mitulpatelp112-svg/Autonomous-drone/frame/ANALYSIS.md

# Frame loads and stresses

Generated by `frame/analysis.py` from the CAD and your Excel motor data. Re-run after
changing `params.py`. Estimates, not a substitute for testing a printed arm.

## Inputs

| Item | Value |
|---|---|
| All-up weight (HOOVO pack + 200 g payload) | **2,367 g** (23.2 N) |
| Printed frame (from CAD, 50% fill) | 672 g |
| Hover thrust per motor | 5.8 N (592 g) |
| Max thrust per motor (Motor sheet, 22.2 V, CF16x5.5) | 17.1 N (1,740 g) |
| Thrust-to-weight | 2.94 : 1 |
| Material | PETG, E = 2000 MPa, strength 45 MPa along lines / 25 MPa across layers, safety factor 3 |

Mass breakdown:

| Part | g |
|---|---|
| Frame (printed, from CAD volume) | 672 |
| 4 x 5010 360KV motor (listing: 80 g) | 320 |
| 4 x 30 A OPTO ESC (ReadytoSky listings: 30 g) | 120 |
| 4 x 16-inch carbon prop (est. 22 g) | 88 |
| Kakute H7 v1.5 (8 g, Holybro) | 8 |
| Power board with XT60 (11 g, listing) | 11 |
| RP3 receiver (4.6 g, RadioMaster) | 5 |
| SEQURE M10 GPS (12 g, SEQURE) | 12 |
| Finder buzzer (est. 4 g) | 4 |
| Wiring, inserts, bolts, straps (est.) | 90 |
| HOOVO 6S 6200 mAh (837 g, listing) | 837 |
| Payload (mission: 200 g) | 200 |

## Arms (cantilever from the body tunnel exit, r = 133 mm, to the motor, r = 340 mm)

| Check | Value | Allowed | Result |
|---|---|---|---|
| Bending moment at the tunnel exit, full thrust | 3.53 N·m | | |
| Peak bending stress (at 133 mm from centre) | 2.24 MPa | 15.0 MPa | OK |
| Tip deflection at hover | 0.49 mm | < 2 mm | OK |
| Tip deflection at full thrust | 1.44 mm | < 4 mm | OK |
| Motor torque reaction | 0.31 N·m | | |
| Torsion shear in the arm walls | 0.13 MPa | 6.7 MPa | OK |
| First bending frequency of an arm | 47 Hz | | |
| Motor speed at hover / full thrust (est.) | 66 / 113 Hz | | |
| Blade-pass at hover (2 blades) | 132 Hz | | |

The arm's first bending frequency (~47 Hz, a rough estimate) sits 28% below the hover rotor speed.
The rotors only pass through it briefly at low throttle (descents), which is normal for printed frames. Do not make the arms
moderately stiffer: that would move the frequency onto hover speed. Instead: balance the props, soft-mount the flight
controller on its grommets, and turn on ArduPilot's throttle-based harmonic notch (the ESCs have no RPM telemetry).
After the first hover, check the FFT in the flight log; if a peak shows up near hover speed, tell me and I will retune the arm.

## Arm-to-body joint (arm in the tunnel, held by 2 x M3)

Under thrust the arm presses **up** on the tunnel roof lip and **down** on the floor at its root,
so the bolts are not loaded in normal flight; they hold the arm in and take crash loads.

| Check | Value | Allowed | Result |
|---|---|---|---|
| Force on the roof lip | 99.2 N | | |
| Force on the floor at the root | 82.2 N | | |
| Bearing stress on the lip (3 mm strip) | 1.18 MPa | 15.0 MPa | OK |
| Roof bending (7 mm roof, 28.5 mm span) | 2.89 MPa | 15.0 MPa | OK |
| Side walls pulled across layers | 0.44 MPa | 8.3 MPa | OK |

## Curved spring legs

Each leg is a C-shaped PETG leaf (28 mm wide, 4.8 mm thick, 144 mm long, bowing 50 mm outward).
On touchdown the C closes up and stores the landing energy in bending. Modelled as a curved beam
(linear, small deflections) with a sideways skid of 0.3 x the vertical force either way.

| Property | Value |
|---|---|
| Spring rate per leg | 2.60 N/mm |
| Sag when sitting on the ground | 2.2 mm |
| Battery-to-ground gap, unloaded / resting | 56.8 / 54.5 mm |

| Touchdown | Energy per leg | Peak force per leg | Leg compresses | Peak deceleration | Leaf stress (limit 30) | Battery gap left |
|---|---|---|---|---|---|---|
| 0.5 m/s on 4 legs | 0.07 J | 19.6 N | 7.5 mm | 3.4 g | 12.4 MPa OK | 47.0 mm |
| 1.0 m/s on 4 legs | 0.30 J | 39.2 N | 15.1 mm | 6.8 g | 24.8 MPa OK | 39.4 mm |
| 1.2 m/s on 4 legs | 0.43 J | 47.0 N | 18.1 mm | 8.1 g | 29.7 MPa OK | 36.4 mm |
| 1.2 m/s on 2 legs | 0.85 J | 66.5 N | 25.6 mm | 5.7 g | 42.0 MPa  | 28.9 mm |

The 0.5 m/s case is a normal ArduPilot landing: the leaf sees about 12 MPa, low enough for
thousands of landings. The 1.2 m/s case is the design hard landing. Tipping onto two legs at 1.2 m/s
reaches 42 MPa, past the ~40 MPa where the leaf is expected to bend for good:
those legs may need replacing after a hard tip-over (print a spare pair).

**Where it gives up.** The leaf is expected to bend permanently or crack at about 40 MPa: 63.3 N per leg,
after 24.4 mm of travel. That is a 1.6 m/s touchdown on 4 legs or 1.1 m/s on 2. The legs are
the weak link on purpose: they are cheap bolt-on parts, and everything behind them stays well inside its limits at that load:

| At the leg's break load (63.3 N) | Value | Allowed | Result |
|---|---|---|---|
| Battery-to-ground gap left | 30.1 mm | > 0 | OK |
| Worst pull on a leg bolt / insert | 41 N | ~167 N (insert pull-out 500 N / 3) | OK |
| Arm bending stress from the leg push | 3.1 MPa | 15.0 MPa | OK |
| Leaf stress from a sideways skid (stiff direction) | 3.2 MPa | 15.0 MPa | OK |

**Printing the legs:** on their side (the C lies flat on the bed), so the printed lines run along the curve and the leaf bends
along its lines, not across layers. Print them solid (100% infill or 6+ walls); a leaf with sparse infill is much
softer and weaker than this model. Each leg is about 40 g printed solid.

## Balance

| Item | Value |
|---|---|
| Centre of gravity height (z = 0 is the body underside) | -0.0 mm |
| Prop plane height (motor + adapter sizes in params.py) | 53.2 mm |
| CG below the props by | 53.3 mm |

A CG below the prop plane (battery underneath) is stable and easy to tune. Keep the battery
centred front-to-back: a 10 mm shift moves the CG 3.5 mm.

## Prop clearances

| Check | Value |
|---|---|
| Gap between neighbouring prop tips | 74.4 mm |
| Prop disc inner edge vs body tip (radius) | 136.8 mm vs 133.0 mm |

## Assumptions to check

- PETG strengths are typical datasheet values; printed parts vary. Weigh and bend-test one arm.
- Insert pull-out (~500 N for an M3 insert in PETG) is a rough figure; it depends on the insert and print settings.
- Motor speed is estimated from KV x volts x 0.85; your Motor sheet has no rpm at 22.2 V.
- Prop weight is an estimate. The motor's height, can diameter and prop adapter are measured from the listing photos;
  the ESC size is from a retailer listing for the same model. Measure yours and update `params.py`.

## Lift capacity

From your Motor sheet (CF16x5.5 at 22.2 V): 1740 g per motor at 12.5 A, so **6.96 kg** of thrust from all
four at full throttle, drawing about 50 A. Empty weight (everything but the payload) is 2,167 g.

**The power board is the limit, not the motors.** It is rated 25 A continuous / 30 A burst (from its listing), and all
four ESCs draw through it. At 30 A the motors make only about **5.08 kg** (4.52 kg at 25 A). Full throttle
(50 A) would overload it. Either keep throttle (and so payload) inside its rating, or wire the ESC power leads to a
board or harness rated for at least 70 A to unlock the motors' full thrust.

| Max payload | With this power board (5.08 kg usable thrust) | With a 70 A+ board (6.96 kg) |
|---|---|---|
| Thrust-to-weight 2.0 (responsive, recommended) | **372 g** | **1,313 g** |
| Thrust-to-weight 1.6 (calm air only, sluggish) | 1,006 g | 2,183 g |

| Payload | All-up weight | Thrust-to-weight (board / motors) | Hover thrust, % of max | Hover current (board limit 25 A) | Hover time (80% of 6200 mAh) | Hard landing limit for the legs |
|---|---|---|---|---|---|---|
| 0 g | 2,167 g | 2.34 / 3.21 | 31% | 8.7 A | 34 min | 1.27 m/s |
| 200 g | 2,367 g | 2.14 / 2.94 | 34% | 9.3 A | 32 min | 1.21 m/s |
| 500 g | 2,667 g | 1.90 / 2.61 | 38% | 11.4 A | 26 min | 1.14 m/s |
| 1,000 g | 3,167 g | 1.60 / 2.20 | 46% | 15.0 A | 20 min | 1.05 m/s |
| 1,313 g | 3,480 g | 1.46 / 2.00 | 50% | 17.3 A | 17 min | 1.00 m/s |

Hover time is the motor sheet's hover current plus 5 W of avionics, no wind or manoeuvring: real flights get less.
The spring legs were sized for the 200 g mission payload; heavier loads lower the touchdown speed they can take
without bending for good (last column). The arms are unaffected by payload: their worst case is full motor thrust.
