mitulpatelp112-svg/Autonomous-drone/frame/CLEARANCE.md

# Clearance and tool-access check

Generated by `frame/clearance.py` from the CAD. Each tool path is a straight cylinder from the screw head
outward (150 mm, a full screwdriver), 7 mm wide for an M3 head (5.5 mm) plus the driver tip.
Cable and strap paths are boxes the size of the bundle. Each is intersected with every printed part, the battery
(152 x 48.5 x 48 mm, from its listing), the motors with prop adapters, the ESCs with their bullets, leads and zip ties, and the prop discs, at the sizes in params.py. Pass = 0 mm³ overlap.

| Check | Paths | Result |
|---|---|---|
| Arm-to-body bolts (M3 x 40, from below) | 16 | all clear |
| Heat-set inserts (soldering iron from above) | 12 | all clear |
| Leg bolts (M3 x 8, from below) | 24 | all clear |
| Heat-set inserts (soldering iron from below) | 8 | all clear |
| Motor screws (M3, from under the pad) | 64 | all clear |
| Motor, ESC and wiring on the arm | 28 | all clear |
| ESC wire path (10 x 5.5 mm bundle) | 12 | all clear |
| Stack bolts (M3, from above) | 4 | all clear |
| GPS mast | 4 | all clear |
| Battery straps (20 mm) | 6 | all clear |
| Connectors | 2 | all clear |
| Part to part | 30 | all clear |

## Blocked paths

None.

## Thinnest walls between holes

| Between | mm |
|---|---|
| Joint bolt hole to wire channel (arm) | 1.8 |
| Joint bolt hole to arm side (before the 2 mm edge fillet) | 2.8 |
| Leg insert hole to nearest lightening slot (along the arm) | 1.9 |
| Mast lock insert (5.7 mm) to mast socket | 1.1 |
| Motor screw head (outer slot end) to pad pocket wall | 0.8 |
| Leg bolt head to spring leaf (below the pad) | 8.2 |
| Leg bolt head to foot | 3.2 |
| Strap slot to bay wall | 1.0 |

## Other clearances

| Item | mm |
|---|---|
| Ground clearance under the battery (legs 110 mm) | 56.8 |
| Gap between neighbouring prop tips | 74.4 |
| Prop disc inner edge to body tip (radius) | 3.8 |
| Prop disc inner edge to GPS mast | 76.2 |

## Order of assembly (so every screw stays reachable)

1. Inserts first: all heat-set inserts go in before anything is attached.
2. Motors onto the arms (screws from under the pad), then ESCs and zip ties.
3. Arms into the body; joint bolts from underneath, with the battery off.
4. Power board and Kakute from above; stack bolts from above.
5. Legs: drone upside down, bolts straight up into the arm undersides.
6. GPS mast into its socket at the back; lock screw from the rear.
7. Battery last, strapped underneath.
