mitulpatelp112-svg/Autonomous-drone/frame/out/parts.png

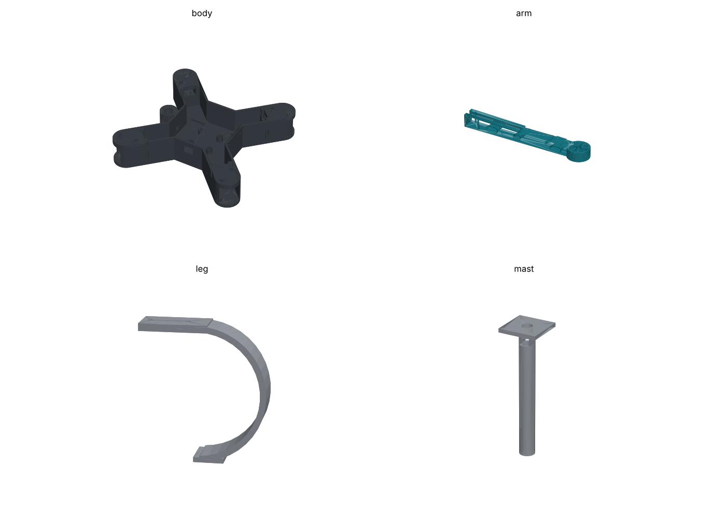
frame/out/parts.png
