mitulpatelp112-svg/Autonomous-drone/frame/out/assembly.step

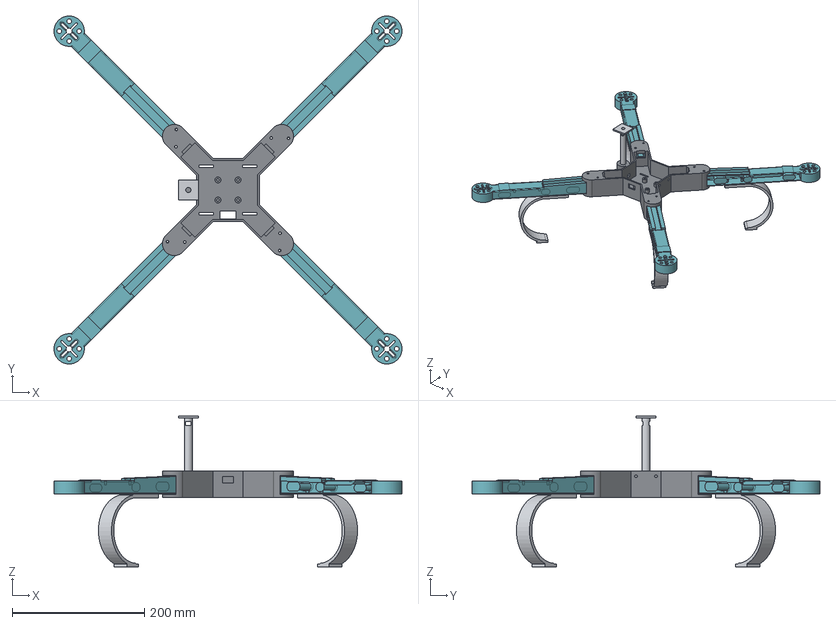
[picture p3: CAD file, 2026-10-27]
frame/out/assembly.step
526.8 x 526.8 x 228.2 mm
arm_1
leg_1
arm_2
leg_2
arm_3
leg_3
arm_4
leg_4
gps_mast
