mitulpatelp112-svg/Autonomous-drone/frame/out/leg.step

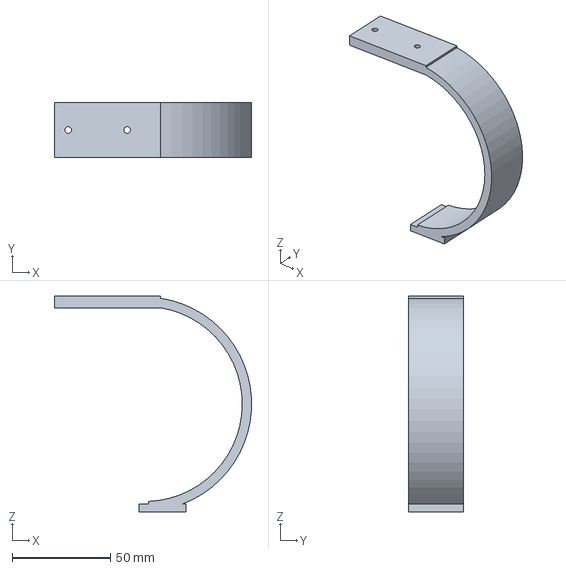
[picture p4: CAD file, 2026-10-27]
frame/out/leg.step
100.3 x 28.0 x 110.0 mm
