mitulpatelp112-svg/Autonomous-drone/frame/out/body.step

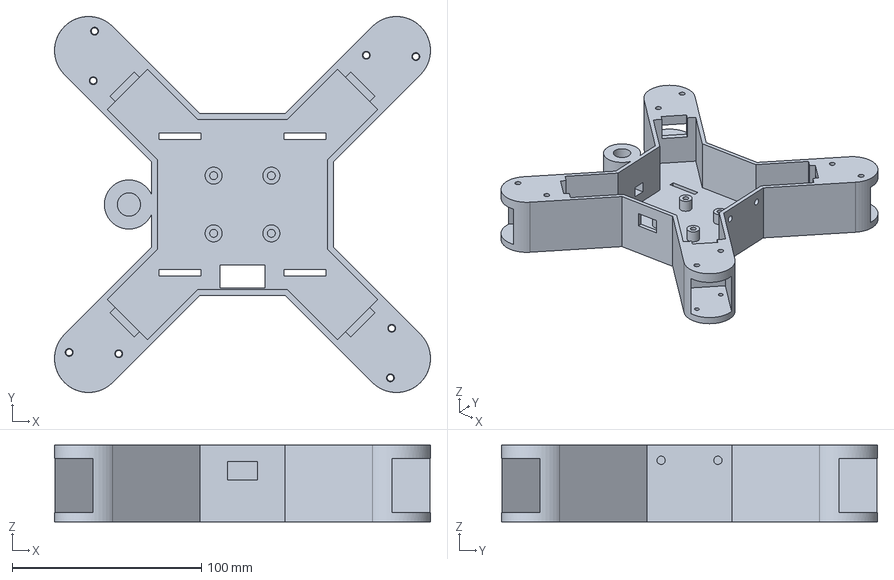
[picture p5: CAD file, 2026-10-27]
frame/out/body.step
198.6 x 198.6 x 40.5 mm
