mitulpatelp112-svg/Autonomous-drone/frame/out/mast.step

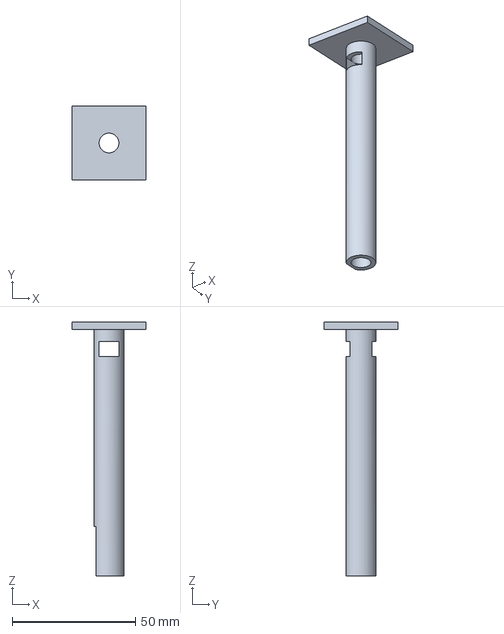
[picture p6: CAD file, 2026-10-27]
frame/out/mast.step
30.0 x 30.0 x 103.0 mm
