mitulpatelp112-svg/Autonomous-drone/frame/out/arm.step

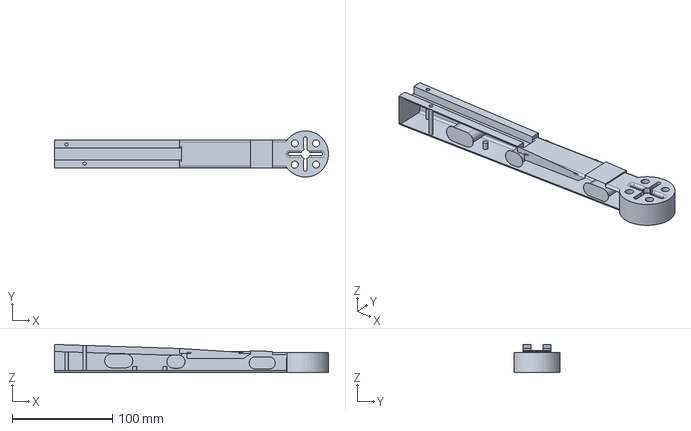
[picture p7: CAD file, 2026-10-27]
frame/out/arm.step
273.0 x 46.0 x 28.0 mm
