mitulpatelp112-svg/Autonomous-drone/(list of files, cad)

Other CAD files:
frame/out/arm.stl
frame/out/body.stl
frame/out/leg.stl
frame/out/mast.stl
