mitulpatelp112-svg/Autonomous-drone/frame/out/assembly.png

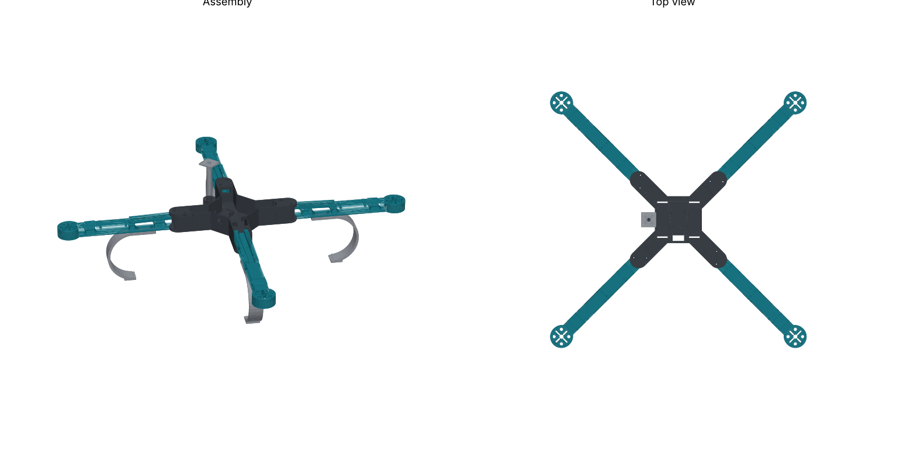
frame/out/assembly.png
