mitulpatelp112-svg/Autonomous-drone/(commit log)

2026-10-20 Wire Update button to the refresh task
    Claude-Session: https://claude.ai/code/session_01XwWvmL249bvbvjAyrSoEUu
2026-10-21 Add signal-flow diagram, part-to-part compatibility table and chosen radio parts
    Wiring diagram now includes the ground station (radio, Nomad, its LiPo,
    laptop) and MAVLink over ExpressLRS. Parts chosen in chat fill empty or
    placeholder cart rows until they are added to the Excel sheet. The page
    falls back to the last known mission goals when the Master Build Sheet
    tab is missing.
    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
2026-10-23 Switch to Kakute H7 v1.5 and track part costs from the cart
    The v2 flight controller is out of production; the v1.5 replaces it. Its
    onboard 5 V and 9 V BECs cover the receiver, GPS and buzzer, so the
    no-BEC ESCs no longer need a 5 V power board. The cart's new Quantity and
    Final cost columns feed a "Spent so far" gauge, a bare part name with a
    price counts as bought, and the motor/ESC specs fall back to the removed
    Specs column's values.
    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
2026-10-23 Mark the Boxer as owned and read bought parts from the cart
    A cart row with a bare name and a price is taken as the part picked for
    that role (flagged as assumed). The Total row is excluded from spending,
    and new Radio Battery and Charger rows are recognised. Telemetry over
    ExpressLRS is treated as a setting rather than a part to buy.
    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
2026-10-23 Check every part's connectors from the product links in the sheet
    The sync now reads each Links cell's hyperlink. Products identified from
    those pages (receiver RP3, Kakute H7 v1.5, HOOVO and OVONIC packs, XT60
    power board, motor/ESC set, props, finder buzzer, SEQURE GPS, Boxer and
    its battery) feed a new connector table. It flags the HOOVO's EC5 plug
    against the XT60 power board, models the primary and backup packs, and
    recommends the HTRC C150 charger.
    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
2026-10-23 Add parametric 680 mm PETG quad frame with load analysis
    CadQuery script builds the body, 4 arms, 4 bolt-on legs and a GPS mast,
    exports STEP (Fusion 360) and STL, and checks 220 mm bed fit and arm/body
    interference. analysis.py computes arm bending, deflection, torsion,
    vibration, joint bearing, landing loads and balance from the Excel motor
    data. README lists print settings, hardware and assembly steps.
    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
    [arm.step, arm.stl, assembly.step, body.step, body.stl, leg.step, leg.stl, mast.step]
2026-10-23 Add interactive 3D frame viewer (click parts for dimensions, pin comments)
    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
2026-10-27 Frame: tool access and clearance fixes, with an automated clearance check
    - GPS mast moved outside the rear wall so the battery strap crosses the bay floor;
    lock screw from the back, 8 mm cable bore and a passage into the bay
    - Wire opening from each arm's top channel into the bay (was a solid wall);
    channel 12 x 7 mm; arm bolts moved either side of the channel
    - Legs: straight strut, bolts 30 mm apart so a driver reaches both from below
    - Strap slots kept inside the bay wall; bigger battery lead slot; USB window
    now actually cut through the wall; bigger motor-pad pocket
    - clearance.py checks 182 tool, cable and strap paths (CLEARANCE.md)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
    [arm.step, arm.stl, assembly.step, body.step, body.stl, leg.step, leg.stl, mast.step]
2026-10-27 Frame: curved PETG spring legs sized for landing energy
    C-shaped leaf (28 x 4.8 mm, bows 50 mm outward) hangs from the mount pad and
    compresses on touchdown: ~7.5 mm at 0.5 m/s, ~18 mm at a 1.2 m/s hard landing
    (29.6 MPa). Legs are the designed weak link: at their ~63 N limit the bolts,
    inserts and arms stay well inside their limits and the battery stays 26 mm
    off the ground. analysis.py now models the leaf as a curved beam; clearance
    check still passes (182 paths).
    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
    [arm.step, assembly.step, body.step, leg.step, leg.stl, mast.step]
2026-10-27 Frame: real motor and ESC sizes, modelled and mounted on the arms
    - hardware.py models the 5010-14 360KV motor (listing: 50x10 stator, 4 mm shaft,
    16/19 mm holes; can and prop adapter measured from the listing photos), the
    30 A OPTO ESC (68 x 25 x 8.7, retailer listing), bullets, leads, zip ties
    - Motor pad: 5 mm with M3 x 8 screws, level landing for the 58 mm base, cross
    slots for any 12-31 mm pattern, cooling vents; ESC on a flat 71 mm seat
    - Battery at its listed 152 x 48.5 x 48 mm
    - Clearance check includes the real parts (210 paths, all clear); viewer shows
    them with sources; out/motor_mount.png shows how they mount
    Claude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
    [arm.step, arm.stl, assembly.step, body.step, leg.step, mast.step]
2026-10-28 Frame: lift capacity in the analysis and the 3D viewer
    Max payload from the Motor sheet thrust curve (16x5.5, 22.2 V): 6.96 kg at full
    throttle (50 A), but the 25/30 A power board caps usable thrust at ~5.1 kg, so
    max payload at thrust-to-weight 2 is ~370 g as built, ~1.3 kg with a 70 A+
    board. Viewer gets a payload slider with weight, thrust-to-weight, hover
    current, hover time and the spring legs' landing limit.
    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
2026-11-02 Add parts receiving checklist page
    Tick-off list of every part to receive (cart items, frame hardware, charger),
    stored in the artifact's database so ticks persist and can be read back.
    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
